jobueh/PUDDING/librelane/runs/RUN_2025-08-30_15-12-42/76-klayout-opengui/klayout_printout.pdf

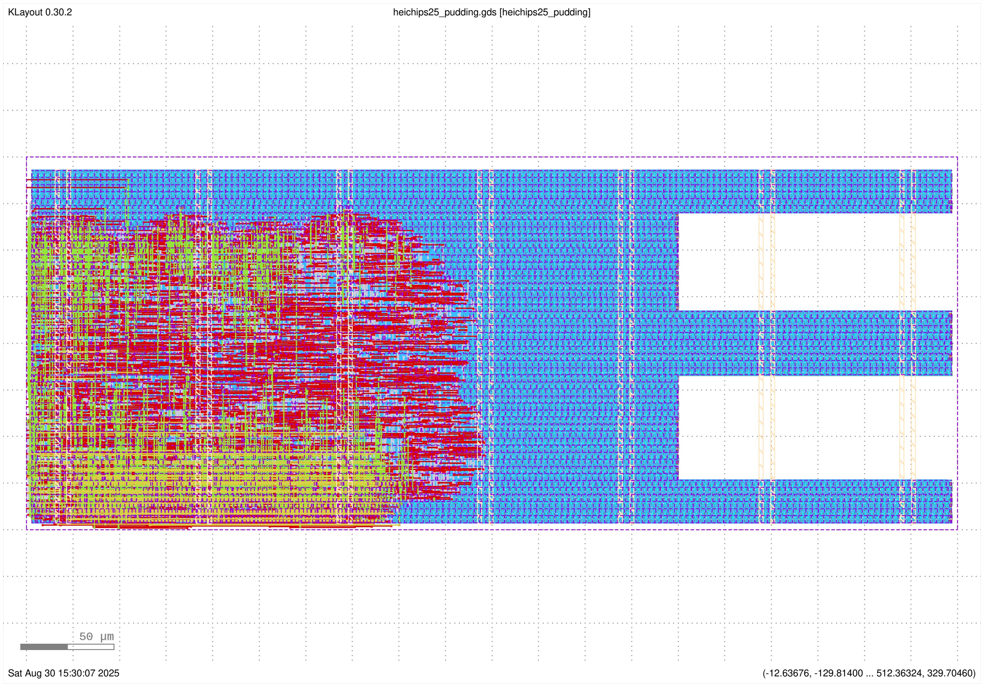
[picture p6: page 1]

KLayout 0.30.2 | heichips25_pudding.gds [heichips25_pudding]
Sat Aug 30 15:30:07 2025 | (-12.63676, -129.81400 ... 512.36324, 329.70460)
