jobueh/PUDDING/gds/dac128module_extracted.cir

* Extracted by KLayout with SG13G2 LVS runset on : 09/02/2026 02:44

.SUBCKT dac128module VSS EN[0]|INP|ON ENB[0]|INN|ONB INP|ON|ON[0]
+ INN|ONB|ONB[0] INP|ON|ON[1] INN|ONB|ONB[1] INP|ON|ON[2] INN|ONB|ONB[2]
+ INP|ON|ON[3] INN|ONB|ONB[3] VDD INP|ON|ON[4] INN|ONB|ONB[4] INP|ON|ON[5]
+ INN|ONB|ONB[5] INP|ON|ON[6] INN|ONB|ONB[6] INP|ON|ON[7] INN|ONB|ONB[7]
+ INP|ON|ON[8] INN|ONB|ONB[8] INP|ON|ON[9] INN|ONB|ONB[9] INP|ON|ON[10]
+ INN|ONB|ONB[10] INP|ON|ON[11] INN|ONB|ONB[11] INP|ON|ON[12] INN|ONB|ONB[12]
+ INP|ON|ON[13] INN|ONB|ONB[13] INP|ON|ON[14] INN|ONB|ONB[14] INP|ON|ON[15]
+ INN|ONB|ONB[15] INP|ON|ON[16] INN|ONB|ONB[16] INP|ON|ON[17] INN|ONB|ONB[17]
+ INP|ON|ON[18] INN|ONB|ONB[18] INP|ON|ON[19] INN|ONB|ONB[19] INP|ON|ON[20]
+ INN|ONB|ONB[20] INP|ON|ON[21] INN|ONB|ONB[21] INP|ON|ON[22] INN|ONB|ONB[22]
+ INP|ON|ON[23] INN|ONB|ONB[23] INP|ON|ON[24] INN|ONB|ONB[24] INP|ON|ON[25]
+ INN|ONB|ONB[25] INP|ON|ON[26] INN|ONB|ONB[26] INP|ON|ON[27] INN|ONB|ONB[27]
+ INP|ON|ON[28] INN|ONB|ONB[28] INP|ON|ON[29] INN|ONB|ONB[29] INP|ON|ON[30]
+ INN|ONB|ONB[30] INP|ON|ON[31] INN|ONB|ONB[31] INP|ON|ON[32] INN|ONB|ONB[32]
+ INP|ON|ON[33] INN|ONB|ONB[33] INP|ON|ON[34] INN|ONB|ONB[34] INP|ON|ON[35]
+ INN|ONB|ONB[35] INP|ON|ON[36] INN|ONB|ONB[36] INP|ON|ON[37] INN|ONB|ONB[37]
+ INP|ON|ON[38] INN|ONB|ONB[38] INP|ON|ON[39] INN|ONB|ONB[39] INP|ON|ON[40]
+ INN|ONB|ONB[40] INP|ON|ON[41] INN|ONB|ONB[41] INP|ON|ON[42] INN|ONB|ONB[42]
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
+ AD=0.162p PS=1.14u PD=2.16u
M$203 OUTN$50 OUTP$50 VSS VSS sg13_lv_nmos L=0.52u W=0.15u AS=0.162p AD=0.0855p
+ PS=2.16u PD=1.14u
M$204 VSS OUTN$50 OUTP$50 VSS sg13_lv_nmos L=0.52u W=0.15u AS=0.0855p AD=0.162p
+ PS=1.14u PD=2.16u
M$205 OUTN$51 OUTP$51 VSS VSS sg13_lv_nmos L=0.52u W=0.15u AS=0.162p AD=0.0855p
+ PS=2.16u PD=1.14u
M$206 VSS OUTN$51 OUTP$51 VSS sg13_lv_nmos L=0.52u W=0.15u AS=0.0855p AD=0.162p
+ PS=1.14u PD=2.16u
M$207 OUTP$117 OUTN$117 VSS VSS sg13_lv_nmos L=0.52u W=0.15u AS=0.162p
+ AD=0.0855p PS=2.16u PD=1.14u
M$208 VSS OUTP$117 OUTN$117 VSS sg13_lv_nmos L=0.52u W=0.15u AS=0.0855p
+ AD=0.162p PS=1.14u PD=2.16u
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
