jobueh/PUDDING/gds/DAC2U64OUT2IN_extracted.cir

* Extracted by KLayout with SG13G2 LVS runset on : 09/02/2026 02:19

.SUBCKT DAC2U64OUT2IN VSS EN[0]|ON ENB[0]|ONB ON|ON[0] ONB|ONB[0] ON|ON[1]
+ ONB|ONB[1] ONB|ONB[2] ON|ON[3] ONB|ONB[3] ON|ON[4] ONB|ONB[4] ON|ON[5]
+ ONB|ONB[5] ON|ON[6] ONB|ONB[6] ON|ON[7] ONB|ONB[7] ONB|ONB[8] ON|ON[9]
+ ONB|ONB[9] ON|ON[10] ONB|ONB[10] ONB|ONB[11] ONB|ONB[12] ONB|ONB[13]
+ ONB|ONB[14] ON|ON[15] ONB|ONB[15] ON|ON[16] ONB|ONB[16] ONB|ONB[17]
+ ONB|ONB[18] ON|ON[19] ONB|ONB[19] ONB|ONB[20] ONB|ONB[21] ON|ON[22]
+ ONB|ONB[22] ONB|ONB[23] ON|ON[24] ONB|ONB[24] ONB|ONB[25] ONB|ONB[26]
+ ONB|ONB[27] ONB|ONB[28] ONB|ONB[29] ONB|ONB[30] ON|ON[31] ONB|ONB[31]
+ ON|ON[32] ONB|ONB[32] ONB|ONB[33] ONB|ONB[34] ONB|ONB[35] ON|ON[36]
+ ONB|ONB[36] ONB|ONB[37] ONB|ONB[38] ONB|ONB[39] ONB|ONB[40] ONB|ONB[41]
+ ONB|ONB[42] ONB|ONB[43] ONB|ONB[44] ONB|ONB[45] ON|ON[46] ONB|ONB[46]
+ ON|ON[47] ONB|ONB[47] ONB|ONB[48] ONB|ONB[49] ON|ON[50] ONB|ONB[50]
+ ONB|ONB[51] ON|ON[52] ONB|ONB[52] ON|ON[53] ONB|ONB[53] ONB|ONB[54]
+ ONB|ONB[55] ONB|ONB[56] ON|ON[57] ONB|ONB[57] ONB|ONB[58] ONB|ONB[59]
+ ON|ON[60] ONB|ONB[60] ON|ON[61] ONB|ONB[61] ONB|ONB[62] ON|ON[63] ONB|ONB[63]
+ ENB[1]|ONB ON|ON[2] ON|ON[8] ON|ON[11] ON|ON[12] ON|ON[13] ON|ON[14]
+ ON|ON[17] ON|ON[18] ON|ON[20] ON|ON[21] ON|ON[23] ON|ON[25] ON|ON[26]
+ ON|ON[27] ON|ON[28] ON|ON[29] ON|ON[30] ON|ON[33] ON|ON[34] ON|ON[35]
+ ON|ON[37] ON|ON[38] ON|ON[39] ON|ON[40] ON|ON[41] ON|ON[42] ON|ON[43]
+ ON|ON[44] ON|ON[45] ON|ON[48] ON|ON[49] ON|ON[51] ON|ON[54] ON|ON[55]
+ ON|ON[56] ON|ON[58] ON|ON[59] ON|ON[62] EN[1]|ON VDD VcascP VbiasP Iout
M$1 \$95 \$96 VSS VSS sg13_lv_nmos L=0.52u W=0.15u AS=0.162p AD=0.0855p
+ PS=2.16u PD=1.14u
M$2 VSS \$95 \$96 VSS sg13_lv_nmos L=0.52u W=0.15u AS=0.0855p AD=0.162p
+ PS=1.14u PD=2.16u
M$3 \$97 \$98 VSS VSS sg13_lv_nmos L=0.52u W=0.15u AS=0.162p AD=0.0855p
+ PS=2.16u PD=1.14u
M$4 VSS \$97 \$98 VSS sg13_lv_nmos L=0.52u W=0.15u AS=0.0855p AD=0.162p
+ PS=1.14u PD=2.16u
M$5 \$99 \$100 VSS VSS sg13_lv_nmos L=0.52u W=0.15u AS=0.162p AD=0.0855p
+ PS=2.16u PD=1.14u
M$6 VSS \$99 \$100 VSS sg13_lv_nmos L=0.52u W=0.15u AS=0.0855p AD=0.162p
+ PS=1.14u PD=2.16u
M$7 \$101 \$102 VSS VSS sg13_lv_nmos L=0.52u W=0.15u AS=0.162p AD=0.0855p
+ PS=2.16u PD=1.14u
M$8 VSS \$101 \$102 VSS sg13_lv_nmos L=0.52u W=0.15u AS=0.0855p AD=0.162p
+ PS=1.14u PD=2.16u
M$9 \$103 \$104 VSS VSS sg13_lv_nmos L=0.52u W=0.15u AS=0.162p AD=0.0855p
+ PS=2.16u PD=1.14u
M$10 VSS \$103 \$104 VSS sg13_lv_nmos L=0.52u W=0.15u AS=0.0855p AD=0.162p
+ PS=1.14u PD=2.16u
M$11 \$105 \$106 VSS VSS sg13_lv_nmos L=0.52u W=0.15u AS=0.162p AD=0.0855p
+ PS=2.16u PD=1.14u
M$12 VSS \$105 \$106 VSS sg13_lv_nmos L=0.52u W=0.15u AS=0.0855p AD=0.162p
+ PS=1.14u PD=2.16u
M$13 \$107 \$108 VSS VSS sg13_lv_nmos L=0.52u W=0.15u AS=0.162p AD=0.0855p
+ PS=2.16u PD=1.14u
M$14 VSS \$107 \$108 VSS sg13_lv_nmos L=0.52u W=0.15u AS=0.0855p AD=0.162p
+ PS=1.14u PD=2.16u
M$15 \$109 \$110 VSS VSS sg13_lv_nmos L=0.52u W=0.15u AS=0.162p AD=0.0855p
+ PS=2.16u PD=1.14u
M$16 VSS \$109 \$110 VSS sg13_lv_nmos L=0.52u W=0.15u AS=0.0855p AD=0.162p
+ PS=1.14u PD=2.16u
M$17 \$111 \$112 VSS VSS sg13_lv_nmos L=0.52u W=0.15u AS=0.162p AD=0.0855p
+ PS=2.16u PD=1.14u
M$18 VSS \$111 \$112 VSS sg13_lv_nmos L=0.52u W=0.15u AS=0.0855p AD=0.162p
+ PS=1.14u PD=2.16u
M$19 \$113 \$114 VSS VSS sg13_lv_nmos L=0.52u W=0.15u AS=0.162p AD=0.0855p
+ PS=2.16u PD=1.14u
M$20 VSS \$113 \$114 VSS sg13_lv_nmos L=0.52u W=0.15u AS=0.0855p AD=0.162p
+ PS=1.14u PD=2.16u
M$21 \$115 \$116 VSS VSS sg13_lv_nmos L=0.52u W=0.15u AS=0.162p AD=0.0855p
+ PS=2.16u PD=1.14u
M$22 VSS \$115 \$116 VSS sg13_lv_nmos L=0.52u W=0.15u AS=0.0855p AD=0.162p
+ PS=1.14u PD=2.16u
M$23 \$117 \$118 VSS VSS sg13_lv_nmos L=0.52u W=0.15u AS=0.162p AD=0.0855p
+ PS=2.16u PD=1.14u
M$24 VSS \$117 \$118 VSS sg13_lv_nmos L=0.52u W=0.15u AS=0.0855p AD=0.162p
+ PS=1.14u PD=2.16u
M$25 \$119 \$120 VSS VSS sg13_lv_nmos L=0.52u W=0.15u AS=0.162p AD=0.0855p
+ PS=2.16u PD=1.14u
M$26 VSS \$119 \$120 VSS sg13_lv_nmos L=0.52u W=0.15u AS=0.0855p AD=0.162p
+ PS=1.14u PD=2.16u
M$27 \$121 \$122 VSS VSS sg13_lv_nmos L=0.52u W=0.15u AS=0.162p AD=0.0855p
+ PS=2.16u PD=1.14u
M$28 VSS \$121 \$122 VSS sg13_lv_nmos L=0.52u W=0.15u AS=0.0855p AD=0.162p
+ PS=1.14u PD=2.16u
M$29 \$123 \$124 VSS VSS sg13_lv_nmos L=0.52u W=0.15u AS=0.162p AD=0.0855p
+ PS=2.16u PD=1.14u
M$30 VSS \$123 \$124 VSS sg13_lv_nmos L=0.52u W=0.15u AS=0.0855p AD=0.162p
+ PS=1.14u PD=2.16u
M$31 \$125 \$126 VSS VSS sg13_lv_nmos L=0.52u W=0.15u AS=0.162p AD=0.0855p
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
M$288 \$279 \$118 VDD VDD sg13_lv_pmos L=0.13u W=0.3u AS=0.057p AD=0.102p
+ PS=0.68u PD=1.28u
M$289 VcascP \$119 \$280 VDD sg13_lv_pmos L=0.13u W=0.3u AS=0.102p AD=0.057p
+ PS=1.28u PD=0.68u
M$290 \$280 \$120 VDD VDD sg13_lv_pmos L=0.13u W=0.3u AS=0.057p AD=0.102p
+ PS=0.68u PD=1.28u
M$291 VcascP \$121 \$281 VDD sg13_lv_pmos L=0.13u W=0.3u AS=0.102p AD=0.057p
+ PS=1.28u PD=0.68u
M$292 \$281 \$122 VDD VDD sg13_lv_pmos L=0.13u W=0.3u AS=0.057p AD=0.102p
+ PS=0.68u PD=1.28u
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
