jobueh/PUDDING/macro/spice/heichips25_pudding.spice

* NGSPICE file created from heichips25_pudding.ext - technology: ihp-sg13g2

* Black-box entry subcircuit for sg13g2_decap_8 abstract view
.subckt sg13g2_decap_8 VDD VSS
.ends

* Black-box entry subcircuit for sg13g2_nand2_1 abstract view
.subckt sg13g2_nand2_1 Y A B VDD VSS
.ends

* Black-box entry subcircuit for sg13g2_fill_1 abstract view
.subckt sg13g2_fill_1 VDD VSS
.ends

* Black-box entry subcircuit for sg13g2_tiehi abstract view
.subckt sg13g2_tiehi VDD VSS L_HI
.ends

* Black-box entry subcircuit for sg13g2_fill_2 abstract view
.subckt sg13g2_fill_2 VDD VSS
.ends

* Black-box entry subcircuit for sg13g2_decap_4 abstract view
.subckt sg13g2_decap_4 VDD VSS
.ends

* Black-box entry subcircuit for sg13g2_mux2_1 abstract view
.subckt sg13g2_mux2_1 A0 A1 S X VDD VSS
.ends

* Black-box entry subcircuit for sg13g2_buf_1 abstract view
.subckt sg13g2_buf_1 A X VDD VSS
.ends

* Black-box entry subcircuit for sg13g2_a21oi_1 abstract view
.subckt sg13g2_a21oi_1 VSS VDD A1 A2 Y B1
.ends

* Black-box entry subcircuit for sg13g2_inv_1 abstract view
.subckt sg13g2_inv_1 VDD Y A VSS
.ends

* Black-box entry subcircuit for sg13g2_dfrbpq_1 abstract view
.subckt sg13g2_dfrbpq_1 RESET_B VSS VDD D Q CLK
.ends

* Black-box entry subcircuit for sg13g2_o21ai_1 abstract view
.subckt sg13g2_o21ai_1 B1 VDD Y VSS A1 A2
.ends

* Black-box entry subcircuit for sg13g2_buf_8 abstract view
.subckt sg13g2_buf_8 A X VDD VSS
.ends

* Black-box entry subcircuit for sg13g2_buf_16 abstract view
.subckt sg13g2_buf_16 X A VDD VSS
.ends

* Black-box entry subcircuit for sg13g2_inv_2 abstract view
.subckt sg13g2_inv_2 Y A VDD VSS
.ends

* Black-box entry subcircuit for sg13g2_inv_8 abstract view
.subckt sg13g2_inv_8 Y A VDD VSS
.ends

* Black-box entry subcircuit for dac128module abstract view
.subckt dac128module VbiasP[1] IOUT VbiasP[0] ON[64] ONB[64] ON[65] ONB[65] ON[66]
+ ONB[66] ON[67] ONB[67] ON[68] ONB[68] ON[69] ONB[69] ON[70] ONB[70] ON[71] ONB[71]
+ ON[72] ONB[72] EN[2] ENB[2] ON[73] ONB[73] ON[74] ONB[74] ON[75] ONB[75] ON[76]
+ ONB[76] ON[77] ONB[77] ON[78] ONB[78] ON[79] ONB[79] ON[80] ONB[80] ON[81] ONB[81]
+ ON[82] ONB[82] ON[83] ONB[83] ON[84] ONB[84] ON[85] ONB[85] ON[86] ONB[86] ON[87]
+ ONB[87] ON[88] ONB[88] ON[89] ONB[89] ON[90] ONB[90] ON[91] ONB[91] ON[92] ONB[92]
+ ON[93] ONB[93] ON[94] ONB[94] ON[95] ONB[95] ON[96] ONB[96] ON[97] ONB[97] ON[98]
+ ONB[98] ON[99] ONB[99] ON[100] ONB[100] ON[101] ONB[101] ON[102] ONB[102] ON[103]
+ ONB[103] ON[104] ONB[104] ON[105] ONB[105] ON[106] ONB[106] ON[107] ONB[107] ON[108]
+ ONB[108] ON[109] ONB[109] ON[110] ONB[110] ON[111] ONB[111] ON[112] ONB[112] ON[113]
+ ONB[113] ON[114] ONB[114] ON[115] ONB[115] ON[116] ONB[116] ON[117] ONB[117] ON[118]
+ ONB[118] ON[119] ONB[119] ON[120] ONB[120] ON[121] ONB[121] ON[122] ONB[122] EN[3]
+ ENB[3] ON[123] ONB[123] ON[124] ONB[124] ON[125] ONB[125] ON[126] ONB[126] ON[127]
+ ONB[127] ON[0] ONB[0] ON[1] ONB[1] ON[2] ONB[2] ON[3] ONB[3] ON[4] ONB[4] ON[5]
+ ONB[5] ON[6] EN[0] ENB[0] ONB[6] ON[7] ONB[7] ON[8] ONB[8] ON[9] ONB[9] ON[10] ONB[10]
+ ON[11] ONB[11] ON[12] ONB[12] ON[13] ONB[13] ON[14] ONB[14] ON[15] ONB[15] ON[16]
+ ONB[16] ON[17] ONB[17] ON[18] ONB[18] ON[19] ONB[19] ON[20] ONB[20] ON[21] ONB[21]
+ ON[22] ONB[22] ON[23] ONB[23] ON[24] ONB[24] ON[25] ONB[25] ON[26] ONB[26] ON[27]
+ ONB[27] ON[28] ONB[28] ON[29] ONB[29] ON[30] ONB[30] ON[31] ONB[31] ON[33] ONB[33]
+ ON[32] ONB[32] ON[34] ONB[34] ON[35] ONB[35] ON[36] ONB[36] ON[37] ONB[37] ON[38]
+ ONB[38] ON[39] ONB[39] ON[40] ONB[40] ON[41] ONB[41] ON[42] ONB[42] ON[43] ONB[43]
+ ON[44] ONB[44] ON[45] ONB[45] ON[46] ONB[46] ON[47] ONB[47] ON[48] ONB[48] ON[49]
+ ONB[49] ON[50] ONB[50] ON[51] ONB[51] ON[52] ONB[52] ON[53] ONB[53] ON[54] ONB[54]
+ ON[55] ONB[55] ON[56] ONB[56] ON[57] ONB[57] ON[58] ONB[58] ON[59] ONB[59] ON[60]
+ ONB[60] ON[61] ONB[61] ON[62] ONB[62] ON[63] ONB[63] EN[1] ENB[1] VcascP[1] VcascP[0]
+ VSS VDD
.ends

* Black-box entry subcircuit for sg13g2_or2_1 abstract view
.subckt sg13g2_or2_1 VSS VDD X B A
.ends

* Black-box entry subcircuit for sg13g2_nor2_1 abstract view
.subckt sg13g2_nor2_1 A B Y VDD VSS
.ends

.subckt heichips25_pudding VGND VPWR clk ena i_in i_out rst_n ui_in[0] ui_in[1] ui_in[2]
+ ui_in[3] ui_in[4] ui_in[5] ui_in[6] ui_in[7] uio_in[0] uio_in[1] uio_in[2] uio_in[3]
+ uio_in[4] uio_in[5] uio_in[6] uio_in[7] uio_oe[0] uio_oe[1] uio_oe[2] uio_oe[3]
+ uio_oe[4] uio_oe[5] uio_oe[6] uio_oe[7] uio_out[0] uio_out[1] uio_out[2] uio_out[3]
+ uio_out[4] uio_out[5] uio_out[6] uio_out[7] uo_out[0] uo_out[1] uo_out[2] uo_out[3]
+ uo_out[4] uo_out[5] uo_out[6] uo_out[7]
XFILLER_39_266 VPWR VGND sg13g2_decap_8
X_2106_ _0743_ net100 state\[25\] VPWR VGND sg13g2_nand2_1
X_2037_ _0703_ net156 _0702_ VPWR VGND sg13g2_nand2_1
XFILLER_36_973 VPWR VGND sg13g2_decap_8
XFILLER_35_483 VPWR VGND sg13g2_decap_8
XFILLER_11_807 VPWR VGND sg13g2_fill_1
X_2350__252 VPWR VGND net251 sg13g2_tiehi
XFILLER_22_144 VPWR VGND sg13g2_decap_8
XFILLER_10_339 VPWR VGND sg13g2_decap_8
X_2426__356 VPWR VGND net355 sg13g2_tiehi
XFILLER_7_7 VPWR VGND sg13g2_fill_1
XFILLER_2_549 VPWR VGND sg13g2_decap_8
XFILLER_18_417 VPWR VGND sg13g2_decap_8
XFILLER_45_203 VPWR VGND sg13g2_decap_8
XFILLER_26_41 VPWR VGND sg13g2_fill_1
XFILLER_42_932 VPWR VGND sg13g2_fill_1
XFILLER_26_63 VPWR VGND sg13g2_fill_2
XFILLER_26_483 VPWR VGND sg13g2_decap_8
XFILLER_13_122 VPWR VGND sg13g2_decap_8
XFILLER_41_420 VPWR VGND sg13g2_decap_8
XFILLER_26_494 VPWR VGND sg13g2_fill_2
XFILLER_13_199 VPWR VGND sg13g2_decap_8
XFILLER_9_126 VPWR VGND sg13g2_decap_8
XFILLER_41_497 VPWR VGND sg13g2_decap_8
XFILLER_42_84 VPWR VGND sg13g2_decap_8
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
X_2335_ net281 VGND VPWR _0151_ daisychain\[23\] clknet_leaf_14_clk sg13g2_dfrbpq_1
XFILLER_29_108 VPWR VGND sg13g2_decap_8
X_2266_ _0823_ net104 state\[105\] VPWR VGND sg13g2_nand2_1
X_2197_ VGND VPWR _0487_ _0788_ _0326_ net86 sg13g2_a21oi_1
XFILLER_1_91 VPWR VGND sg13g2_decap_8
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
