jobueh/PUDDING/xschem/simulation/dac128module.spice

** sch_path: /home/cmaier/EDA/PUDDING/xschem/dac128module.sch
.subckt dac128module Iout ON[63] ON[62] ON[61] ON[60] ON[59] ON[58] ON[57] ON[56] ON[55] ON[54] ON[53] ON[52] ON[51] ON[50] ON[49]
+ ON[48] ON[47] ON[46] ON[45] ON[44] ON[43] ON[42] ON[41] ON[40] ON[39] ON[38] ON[37] ON[36] ON[35] ON[34] ON[33] ON[32] ON[31] ON[30]
+ ON[29] ON[28] ON[27] ON[26] ON[25] ON[24] ON[23] ON[22] ON[21] ON[20] ON[19] ON[18] ON[17] ON[16] ON[15] ON[14] ON[13] ON[12] ON[11]
+ ON[10] ON[9] ON[8] ON[7] ON[6] ON[5] ON[4] ON[3] ON[2] ON[1] ON[0] ONB[63] ONB[62] ONB[61] ONB[60] ONB[59] ONB[58] ONB[57] ONB[56]
+ ONB[55] ONB[54] ONB[53] ONB[52] ONB[51] ONB[50] ONB[49] ONB[48] ONB[47] ONB[46] ONB[45] ONB[44] ONB[43] ONB[42] ONB[41] ONB[40] ONB[39]
+ ONB[38] ONB[37] ONB[36] ONB[35] ONB[34] ONB[33] ONB[32] ONB[31] ONB[30] ONB[29] ONB[28] ONB[27] ONB[26] ONB[25] ONB[24] ONB[23] ONB[22]
+ ONB[21] ONB[20] ONB[19] ONB[18] ONB[17] ONB[16] ONB[15] ONB[14] ONB[13] ONB[12] ONB[11] ONB[10] ONB[9] ONB[8] ONB[7] ONB[6] ONB[5] ONB[4]
+ ONB[3] ONB[2] ONB[1] ONB[0] VSS VDD Vpcbias[0] EN[1] EN[0] ENB[1] ENB[0] ON[127] ON[126] ON[125] ON[124] ON[123] ON[122] ON[121] ON[120]
+ ON[119] ON[118] ON[117] ON[116] ON[115] ON[114] ON[113] ON[112] ON[111] ON[110] ON[109] ON[108] ON[107] ON[106] ON[105] ON[104] ON[103]
+ ON[102] ON[101] ON[100] ON[99] ON[98] ON[97] ON[96] ON[95] ON[94] ON[93] ON[92] ON[91] ON[90] ON[89] ON[88] ON[87] ON[86] ON[85] ON[84]
+ ON[83] ON[82] ON[81] ON[80] ON[79] ON[78] ON[77] ON[76] ON[75] ON[74] ON[73] ON[72] ON[71] ON[70] ON[69] ON[68] ON[67] ON[66] ON[65]
+ ON[64] ONB[127] ONB[126] ONB[125] ONB[124] ONB[123] ONB[122] ONB[121] ONB[120] ONB[119] ONB[118] ONB[117] ONB[116] ONB[115] ONB[114]
+ ONB[113] ONB[112] ONB[111] ONB[110] ONB[109] ONB[108] ONB[107] ONB[106] ONB[105] ONB[104] ONB[103] ONB[102] ONB[101] ONB[100] ONB[99]
+ ONB[98] ONB[97] ONB[96] ONB[95] ONB[94] ONB[93] ONB[92] ONB[91] ONB[90] ONB[89] ONB[88] ONB[87] ONB[86] ONB[85] ONB[84] ONB[83] ONB[82]
+ ONB[81] ONB[80] ONB[79] ONB[78] ONB[77] ONB[76] ONB[75] ONB[74] ONB[73] ONB[72] ONB[71] ONB[70] ONB[69] ONB[68] ONB[67] ONB[66] ONB[65]
+ ONB[64] EN[3] EN[2] ENB[3] ENB[2] Vpcbias[1]
*.PININFO Iout:O ON[63:0]:I ONB[63:0]:I VSS:B VDD:B Vpcbias[0]:B EN[1:0]:I ENB[1:0]:I ON[127:64]:I ONB[127:64]:I EN[3:2]:I
*+ ENB[3:2]:I Vpcbias[1]:B
Mcbias[0] Vpcbias[0] Vpcbias[0] Vpbias[0] VDD sg13_lv_pmos w=5.85u l=0.15u ng=1 m=2
xref[1] VDD Vpbias[0] EN[1] ENB[1] Vpbias[0] Vpcbias[0] VSS unitsource2u
xref[0] VDD Vpbias[0] EN[0] ENB[0] Vpbias[0] Vpcbias[0] VSS unitsource2u
xsrc[63] VDD Vpbias[0] ON[63] ONB[63] Iout Vpcbias[0] VSS unitsource2u
xsrc[62] VDD Vpbias[0] ON[62] ONB[62] Iout Vpcbias[0] VSS unitsource2u
xsrc[61] VDD Vpbias[0] ON[61] ONB[61] Iout Vpcbias[0] VSS unitsource2u
xsrc[60] VDD Vpbias[0] ON[60] ONB[60] Iout Vpcbias[0] VSS unitsource2u
xsrc[59] VDD Vpbias[0] ON[59] ONB[59] Iout Vpcbias[0] VSS unitsource2u
xsrc[58] VDD Vpbias[0] ON[58] ONB[58] Iout Vpcbias[0] VSS unitsource2u
xsrc[57] VDD Vpbias[0] ON[57] ONB[57] Iout Vpcbias[0] VSS unitsource2u
xsrc[56] VDD Vpbias[0] ON[56] ONB[56] Iout Vpcbias[0] VSS unitsource2u
xsrc[55] VDD Vpbias[0] ON[55] ONB[55] Iout Vpcbias[0] VSS unitsource2u
xsrc[54] VDD Vpbias[0] ON[54] ONB[54] Iout Vpcbias[0] VSS unitsource2u
xsrc[53] VDD Vpbias[0] ON[53] ONB[53] Iout Vpcbias[0] VSS unitsource2u
xsrc[52] VDD Vpbias[0] ON[52] ONB[52] Iout Vpcbias[0] VSS unitsource2u
xsrc[51] VDD Vpbias[0] ON[51] ONB[51] Iout Vpcbias[0] VSS unitsource2u
xsrc[50] VDD Vpbias[0] ON[50] ONB[50] Iout Vpcbias[0] VSS unitsource2u
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
