jobueh/PUDDING/librelane/runs/RUN_2026-02-11_00-01-28/final/nl/heichips25_pudding.nl.v

module heichips25_pudding (clk,
    ena,
    rst_n,
    ui_in,
    uio_in,
    uio_oe,
    uio_out,
    uo_out);
 input clk;
 input ena;
 input rst_n;
 input [7:0] ui_in;
 input [7:0] uio_in;
 output [7:0] uio_oe;
 output [7:0] uio_out;
 output [7:0] uo_out;

 wire _0000_;
 wire _0001_;
 wire _0002_;
 wire _0003_;
 wire _0004_;
 wire _0005_;
 wire _0006_;
 wire _0007_;
 wire _0008_;
 wire _0009_;
 wire _0010_;
 wire _0011_;
 wire _0012_;
 wire _0013_;
 wire _0014_;
 wire _0015_;
 wire _0016_;
 wire _0017_;
 wire _0018_;
 wire _0019_;
 wire _0020_;
 wire _0021_;
 wire _0022_;
 wire _0023_;
 wire _0024_;
 wire _0025_;
 wire _0026_;
 wire _0027_;
 wire _0028_;
 wire _0029_;
 wire _0030_;
 wire _0031_;
 wire _0032_;
 wire _0033_;
 wire _0034_;
 wire _0035_;
 wire _0036_;
 wire _0037_;
 wire _0038_;
 wire _0039_;
 wire _0040_;
 wire _0041_;
 wire _0042_;
 wire _0043_;
 wire _0044_;
 wire _0045_;
 wire _0046_;
 wire _0047_;
 wire _0048_;
 wire _0049_;
 wire _0050_;
 wire _0051_;
 wire _0052_;
 wire _0053_;
 wire _0054_;
 wire _0055_;
 wire _0056_;
 wire _0057_;
 wire _0058_;
 wire _0059_;
 wire _0060_;
 wire _0061_;
 wire _0062_;
 wire _0063_;
 wire _0064_;
 wire _0065_;
 wire _0066_;
 wire _0067_;
 wire _0068_;
 wire _0069_;
 wire _0070_;
 wire _0071_;
 wire _0072_;
 wire _0073_;
 wire _0074_;
 wire _0075_;
 wire _0076_;
 wire _0077_;
 wire _0078_;
 wire _0079_;
 wire _0080_;
 wire _0081_;
 wire _0082_;
 wire _0083_;
 wire _0084_;
 wire _0085_;
 wire _0086_;
 wire _0087_;
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
    .D(_0293_),
    .Q(\daisychain[37] ),
    .CLK(clknet_leaf_17_clk));
 sg13g2_dfrbpq_1 _2348_ (.RESET_B(net407),
    .D(_0294_),
    .Q(\daisychain[38] ),
    .CLK(clknet_leaf_13_clk));
 sg13g2_dfrbpq_1 _2349_ (.RESET_B(net405),
    .D(_0295_),
    .Q(\daisychain[39] ),
    .CLK(clknet_leaf_12_clk));
 sg13g2_dfrbpq_1 _2350_ (.RESET_B(net403),
    .D(_0296_),
    .Q(\daisychain[40] ),
    .CLK(clknet_leaf_12_clk));
 sg13g2_dfrbpq_1 _2351_ (.RESET_B(net401),
    .D(_0297_),
    .Q(\daisychain[41] ),
    .CLK(clknet_leaf_13_clk));
 sg13g2_dfrbpq_1 _2352_ (.RESET_B(net399),
    .D(_0298_),
    .Q(\daisychain[42] ),
    .CLK(clknet_leaf_13_clk));
 sg13g2_dfrbpq_1 _2353_ (.RESET_B(net397),
    .D(_0299_),
    .Q(\daisychain[43] ),
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
