jobueh/PUDDING/src/heichips25_pudding.sv

// SPDX-FileCopyrightText: © 2025 Luis Ardila, Jonas Buehler, Christoph Maier
// SPDX-License-Identifier: Apache-2.0

// Adapted from the Tiny Tapeout template
// minimum design: 128 DAC sources only

`default_nettype none

module heichips25_pudding(
    input  wire [7:0] ui_in,    // Dedicated inputs
    output wire [7:0] uo_out,   // Dedicated outputs
    input  wire [7:0] uio_in,   // IOs: Input path
    output wire [7:0] uio_out,  // IOs: Output path
    output wire [7:0] uio_oe,   // IOs: Enable path (active high: 0=input, 1=output)
    input  wire       ena,      // always 1 when the design is powered, so you can ignore it
    input  wire       clk,      // clock
    input  wire       rst_n,    // reset_n - low to reset
    inout  wire       i_in,	// input (reference) current
    inout  wire       i_out,	// output (DAC) current
    inout VPWR,
    inout VGND
);

//(* keep = "yes" *) wire VPWR;
//(* keep = "yes" *) wire VGND;
   
    // List all unused inputs to prevent warnings
    wire[1:0] iref;
    wire[1:0] bias;
    wire _unused = &{ena, uio_in[7:0], ui_in[7:5], bias};

    logic[3:0] stateen, stateenp, stateenn;

    logic datum, shift, transfer, dir;

    logic[127:0] daisychain;
    logic[127:0] state;

    assign iref     = {2{i_in}};
    assign datum    = ui_in[0];
    assign shift    = ui_in[1];
    assign transfer = ui_in[2];
    assign dir      = ui_in[3];

    assign stateen = {4{ui_in[4]}};

    always_ff @(posedge clk) 
    begin
        if (!rst_n) 
        begin
            daisychain <= '0;
            state <= '0;
        end 
        else 
        begin
            if (transfer) 
            begin
                if (dir)
                    state <= daisychain;
                else
                    daisychain <= state;
            end
            else if (shift)
            begin
                daisychain <= {daisychain[126:0],datum};
            end
        end
    end

    
assign uo_out  = daisychain[127:120];
assign uio_out = state[127:120];
assign uio_oe  = 8'hFF;

    digital4 digitalen (
    .in(stateen[3:0]),
    .outp(stateenp[3:0]),
    .outn(stateenn[3:0])
    );


(* keep_hierarchy = "yes", keep = "yes" *) dac128module dac (
    .IOUT(i_out),
    .VcascP(iref),
    .VbiasP(bias),
    .ON(state[127:0]),
    .ONB(~state[127:0]),
    .EN(stateenp[3:0]),
    .ENB(stateenn[3:0]),
    .VDD(VPWR),
    .VSS(VGND)
    );

endmodule

module digital4(
    input  logic [3:0] in,
    output logic [3:0] outn,
    output logic [3:0] outp
);
    // 4 instances, each bit wired to one instance
  genvar i;
      for (i = 0; i < 4; i++) begin : g
          inverterpair u (
              .IN   (in[i]),
              .OUTN (outn[i]),
              .OUTP (outp[i])
          );
  end
endmodule

// File: inverterpair.sv
// SystemVerilog: simple ON - ON_N logic for the current mirrors

module inverterpair (
    input logic IN,
    output logic OUTN,
    output logic OUTP
);
(* keep *) sg13g2_inv_1 inv1 (.Y(OUTN), .A(IN));
(* keep *) sg13g2_inv_1 inv2 (.Y(OUTP), .A(OUTN));
endmodule
