jobueh/PUDDING/src/dac128module.v

// File: dac128module.v
// SystemVerilog: 128 unit source DAC module digital placeholder
// Yosys hints: blackbox + keep_hierarchy.
(* blackbox *)
module dac128module (
    inout IOUT,
    inout [1:0] VcascP,
    inout [1:0] VbiasP,
    input [127:0] ON,
    input [127:0] ONB,
    input [3:0] EN,
    input [3:0] ENB,
    inout VDD,
    inout VSS
);
endmodule
