jobueh/PUDDING/(commit log)

2025-08-07 calls.txt : notes on calling tools in the chain
2025-08-07 Add schematics
    [DAC_SW.sch, DAC_TOP.sch, Pmirror_StdCell.sch, Pmirrors_top.sch]
2025-08-08 xschem/*.sch *.sym * moved from schematic
    [DAC_SW.sch, DAC_TOP.sch, Pmirror_StdCell.sch, Pmirrors_top.sch]
2025-08-08 xschem/DAC_TOP.sch Pmirrors_top.sch : made paths to subcircuits relative, so it works for everybody [?, at least #worksforme]
    [DAC_TOP.sch, Pmirrors_top.sch]
2025-08-08 dac_word_correction code
    Performing correction on the dac data word by interpolation.
    [dac_word_correction.sv]
2025-08-09 DoNotLitter/CryoChips/Design_of_Low-Voltage_and_Low-Power_Cryogenic_CMOS_Voltage_Reference_Circuits.pdf : start literature collection
2025-08-11 AnalogFlow.md README.md : extra markdown page for analog design flow
2025-08-12 gds/pmos_switch_array_botched.gds : botched pcells without n tap and "shared gate strap"
2025-08-14 gds/pcascsrc.gds : add minimum DRC drain contact. w=300nm is minimum width to fit contact
2025-08-14 gds/switched_pmos_cascode.gds python/make_gds.py : minimum DRC clean switched cascode with gate and drain contacts, generating python script
2025-08-14 klayout_printout.pdf : swsources16 printout
2025-08-15 Split ON and ON_N
    [DAC_SW.sch, DAC_SW_TOP.sch, DAC_TOP.sch, DC_sim.sch, Pmirror_StdCell.sch, Pmirrors_top.sch, tran_sim.sch]
2025-08-15 tb/*.sch schematic/*.sch : changed absolute to relative path references for portability
    [DAC_SW_TOP.sch, DAC_TOP.sch, DC_sim.sch, Pmirrors_top.sch, tran_sim.sch]
2025-08-15 tb/DC_sim.sch : fixed mkdir incompatibility
    [DC_sim.sch]
2025-08-15 schematic/simulation/.spiceinit tb/simulation/.spiceinit tb/simulations/.spiceinit : (maybe) redundant copies of .spiceinit to make simulations work
2025-08-16 python/pcell_pmos_switch_array.py gds/pmos_switch_array_botched.gds: still nonsensical ChatGPT cascode switch generator
2025-08-16 xschem/DC_sim.sch tran_sim.sch DAC_TOP.sch DAC_SW_TOP.sch Pmirrors_top.sch : moved from tb and schematic, path fixed to local directory
    [DAC_SW_TOP.sch, DAC_TOP.sch, DC_sim.sch, Pmirrors_top.sch, tran_sim.sch]
2025-08-16 xschem/Nmirror.sch Nmirror.sym : self-cascoded NMOS mirror to generate two DAC bias currents
    [Nmirror.sch]
2025-08-16 flake.nix : add gaw waveform viewer
    [test_Nmirror_DC.sch]
2025-08-16 xschem/Nmirror.sch test_Nmirror_DC.sch : work in progress, try to get a grasp of setting a good operating point
    [Nmirror.sch, test_Nmirror_DC.sch]
2025-08-16 xschem/Nmirror.sch : shotgun redimensioning
    [Nmirror.sch]
2025-08-16 xschem/test_Nmirror_DC.sch : work in progress: measure g_m/I_d, g_m/g_o
    [test_Nmirror_DC.sch]
2025-08-16 AnalogFlow.md : actually characterize the current sources before final layout
2025-08-16 xschem/test_Nmirror_DC.sch : plot gm/Id, gm/go of transistors. Work in progress, now dimension the transistors
    [test_Nmirror_DC.sch]
2025-08-16 xschem/pcascsrc.sch pcascsrc.sym test_pcascsrc_DC.sch : testing cascoded source as laid out
    [pcascsrc.sch, test_pcascsrc_DC.sch]
2025-08-16 xschem/test_pcascsrc_DC.sch : plot gm/Id and gm/go
    [test_pcascsrc_DC.sch]
2025-08-16 xschem/test_pcascsrc_DC.sch : bias cascodes relative to source bias
    [test_pcascsrc_DC.sch]
2025-08-16 xschem/test_pcascsrc_DC.sch : vary output voltage, 10nA ... 1uA bias
    [test_pcascsrc_DC.sch]
2025-08-16 Pmirror LVS and DRC clean
    [Pmirror_StdCell.sch]
2025-08-16 xschem/test_pmosdiode.sch : test simple pmos diode as bias for the cascode, slow corner There seems to be no temperature dependence of the models
    [test_pmosdiode.sch]
2025-08-16 xschem/test_pmosdiode.sch : test simple pmos diode as bias for the cascode, fast corner There seems to be no temperature dependence of the models
    [test_pmosdiode.sch]
2025-08-16 xschem/test_pcascsrc_DC.sch : use diode connected pmos transistor to generate cascode bias
    [test_pcascsrc_DC.sch]
2025-08-16 xschem/test_pcascsrc_DC.sch : use diode connected pmos transistor to generate cascode bias, fast corner
    [test_pcascsrc_DC.sch]
2025-08-16 xschem/test_pcascsrc_DC.sch : use diode connected pmos transistor to generate cascode bias, slow corner
    [test_pcascsrc_DC.sch]
2025-08-16 xschem/test_pcascsrc_DC.sch : use diode connected pmos transistor to generate cascode bias, typical (non-)corner
    [test_pcascsrc_DC.sch]
2025-08-17 gds/swcascsrc_playground.gds : add NWELL pin
2025-08-17 xschem/pcascsrc.sch pcascsrc.sym test_pcascsrc_DC.sch : add separate NWELL pin for LvS
    [pcascsrc.sch, test_pcascsrc_DC.sch]
2025-08-17 gds/swsources16.gds : connect VDD and NWELL, connect Iout, tbd: wire cascode switches
2025-08-17 gds/swcascsrc_playground.gds PCASCSRC_extracted.cir : switch contact to metal2, LvS clean
2025-08-17 gds/swsources16.gds : DRC clean, with switch inputs
2025-08-17 xschem/pcascsrc16.sch pcascsrc16.sym : row of 16 switched current sources
    [pcascsrc16.sch]
2025-08-17 gds/PCASCSRC16_extracted.cir xschem/simulation/pcascsrc16.spice : layout and schematic extracted netlists, LvS matches
2025-08-17 xschem/test_pcascsrc16_DC.sch : test circuit with 2 unit sources at the ends of the array as reference current input and end-of-row sources (for better matching)
    [test_pcascsrc16_DC.sch]
2025-08-17 thermometer encoder simulated and implemented using librelane
2025-08-17 gds/PCASCSRC_extracted.cir : extracted schematic from LvS, clean
2025-08-18 gds/pcascsrc.gds : add substrate tap, get rid of separate NWELL pin
2025-08-18 change schematics to reflect added well tap to pcascsrc layout
    [pcascsrc.sch, pcascsrc16.sch, test_pcascsrc16_DC.sch, test_pcascsrc_DC.sch]
2025-08-18 added non_overlap but it fails due to logic loop, it needs to be an analog block
    [heichips25_template.sv, non_overlap.sv]
2025-08-18 First run of the digital flow
2025-08-18 AnalogFlow.md : document some analog layout gotchas, in case someone wonders why there is no apparent progress
2025-08-18 analog non_overlap module
    [non_overlap.sch, non_overlap_dc_sim.sch, non_overlap_single_dc_sim.sch, non_overlap_top.sch, non_overlap_tran_logic.sch]
2025-08-18 pcascsrc.gds switched_pmos_cascode.gds PCASCSRC_extracted.cir : changed Iout pin, LvS clean
2025-08-18 pcascsrc.gds PCASCSRC_extracted.cir : top pin to metal1, LvS clean
2025-08-18 switched_pmos_cascode.gds pcascsrc.gds PCASCSRC_extracted.cir : corrected minimum metal1 area DRC error, LvS clean
2025-08-19 gds/pcascrefL.gds pcascrefR.gds PCASCSRCREFL_extracted.cir PCASCSRCREFR_extracted.cir : left and right diode connected end columns no LvS attempted
2025-08-19 pcsource.gds PCSOURCE_extracted.cir : switched cascoded source with metal1 VbiasP, extracted netlist, no LvS yet
2025-08-19 xschem/pcsource.sch pcsource.sym xschem/simulation/pcsource.spice gds/PCSOURCE_extracted.cir : (backannotated) schematic and symbol, extracted netlist from layout, LvS matches
    [pcsource.sch]
2025-08-19 xschem/pcsource16.sch pcsource16.sym test_pcsource_DC.sch test_pcsource16_DC.sch : DC test schematics for pcsource, 16 unit pcsource array
    [pcsource16.sch, test_pcsource16_DC.sch, test_pcsource_DC.sch]
2025-08-19 pcsource66.gds : 64+2 sources in a row (2 in, 64 out), not yet wired
2025-08-19 change location of analog files and simulation of analog non-overlap module now works
    [non_overlap.sch, non_overlap_dc_sim.sch, non_overlap_single_dc_sim.sch, non_overlap_single_tran_sim.sch, non_overlap_top.sch]
2025-08-19 gds/pcsource66x2.gds : array with two rows of 66 unit sources each, rotated by 180 degrees, not wired yet
2025-08-19 remove digital non_overlap source from the config file and add obstruction for analog circuit integration
2025-08-20 xschem/non_overlap*.sch non_overlap*.sym : copied from src/xschem/non_overlap
    [non_overlap.sch, non_overlap_dc_sim.sch, non_overlap_single_dc_sim.sch, non_overlap_top.sch, non_overlap_tran_logic.sch]
2025-08-20 xschem/non_overlap_tran_logic.sch non_overlap_single_dc_sim.sch : standard cell libraries included, simulation runs now and yields rather bad results
    [non_overlap_single_dc_sim.sch, non_overlap_tran_logic.sch]
2025-08-20 pymacros/switched_pmos_cascode.lym : basic pCell to draw a switched PMOS cascode
2025-08-21 gds/refsource_connect.gds : wire to turn pcsource.gds into input reference, work in progress
2025-08-21 xschem/non_overlap_tran_logic.sch : use .param
    [non_overlap_tran_logic.sch]
2025-08-21 non_overlap.sch non_overlap_tran_logic.sch
    [non_overlap.sch, non_overlap_tran_logic.sch]
2025-08-21 gds/dac128out4in.gds : add diode connection stubs to 2x(64+2) switched source array
2025-08-21 gds/refsource_connect.gds : change reference current source connection layout
2025-08-21 dac128out4in.gds cascodewire.gds cascodevia.gds refsource_connect.gds switchwire.gds : wired 128 bit DAC with 4 diode connected input unit transistors
2025-08-22 gds/dac_sw.gds switcharray.gds : layout placement test for DAC_SW, minimal version. Pitch: 1.53 um
2025-08-24 hand routed non_overlap from standard cells
    [non_overlap.sch]
2025-08-24 Add xschem non-overlap switches
    [non_overlap.sch, non_overlap_tran_logic.sch]
2025-08-24 xschem/non_overlap.sch non_overlap_tran_logic.sch : named nets, tweaked .options
    [non_overlap.sch, non_overlap_tran_logic.sch]
2025-08-24 xschem/cascodeswitch_pmos.sch cascodeswitch_pmos.sym : nicely redrawn schematic
    [cascodeswitch_pmos.sch]
2025-08-24 xschem/switch_logic.sch switch_logic.sym test_switchedsources_tran.sch : switched source transient test platform
    [switch_logic.sch, test_switchedsources_tran.sch]
2025-08-25 xschem/test_switchedsources_tran.sch : test switching behavior
    [test_switchedsources_tran.sch]
2025-08-25 xschem/pcascsrc.sch pcascsrc.sym test_pcascsrc_DC.sch test_pcsource_DC.sch test_switchedsources_tran.sch : now with parameter passing
    [pcascsrc.sch, test_pcascsrc_DC.sch, test_pcsource_DC.sch, test_switchedsources_tran.sch]
2025-08-25 xschem/non_overlap_tran_logic.sch : now with temperature dependence
    [non_overlap_tran_logic.sch]
2025-08-25 xschem/non_overlap.sch non_overlap_top.sym
    [non_overlap.sch]
2025-08-25 xschem/non_overlap_single_tran_sim.sch non_overlap_luis.sch non_overlap_luis.sym : from Luis
    [non_overlap_luis.sch, non_overlap_single_tran_sim.sch]
2025-08-25 xschem/switch_logic_RS_dly3.sch switch_logic_RS_dly3.sym test_switchedsources_tran.sch : Luis's RS latch creates an OVERLAPPING clock :-/
    [switch_logic_RS_dly3.sch, test_switchedsources_tran.sch]
2025-08-25 xschem/test_switchedsources_tran.sch : get rid of redundant plot
    [test_switchedsources_tran.sch]
2025-08-25 xschem/non_overlap.sch switch_logic_RS_dly3.sch : make the switch logic NON-overlapping instead of overlapping
    [non_overlap.sch, switch_logic_RS_dly3.sch]
2025-08-25 xschem/switch_logic_RS.sch switch_logic_RS.sym test_switchedsources_tran.sch : level shifter as non-overlapping logic
    [switch_logic_RS.sch, test_switchedsources_tran.sch]
2025-08-25 sudelbuecher/switch_logic_RS.png : level shifter circuit as non-overlapping signal generator. Transistor size matters.
2025-08-26 src/thermometer_encoder.sv : fix typo
    [thermometer_encoder.sv]
2025-08-26 gds/dac_sw.gds switcharray.gds : communicate work-in-progress
2025-08-26 gds/switcharray.gds : work in progress
2025-08-26 xschem/nonoverlap.sch nonoverlap.sym simulation/nonoverlap.spice : non-overlap RS latch as laid out
    [nonoverlap.sch]
2025-08-26 xschem/switch_logic_nonoverlap.sch switch_logic_nonoverlap.sym test_switchedsources_tran.sch : simulat non-overlap latch as laid out
    [switch_logic_nonoverlap.sch, test_switchedsources_tran.sch]
2025-08-26 nonoverlap.sch simulation/nonoverlap.spice : fix nmos length
    [nonoverlap.sch]
2025-08-26 gds/dac_sw.gds switcharray.gds : DRC clean, work in progress
2025-08-27 gds/cascodedrive.gds switcharray.gds : move origin, fix DRC error
2025-08-27 sudelbuecher/nonoverlap_*.png : screenshots of nonoverlap blocks that tend to get optimized away by the digital synthesis flow
2025-08-27 gds/pcsource2u.gds : Towards a 2um width switched current source. Work in progress
2025-08-27 gds/pcsource2u.gds PCSOURCE2U_extracted.cir xschem/pcsource2u.sch pcsource2u.sym simulation/pcsource2u.spice : resized source witch schematic, symbol, and netlists for (clean) LvS
    [pcsource2u.sch]
2025-08-27 xschem/* : adapt test schematics to altered layout, make parametric, add bypass capacitors
    [pcascsrc16.sch, pcsource16.sch, test_pcascsrc16_DC.sch, test_pcascsrc_DC.sch, test_pcsource16_DC.sch, test_pcsource_DC.sch, test_switchedsources_tran.sch]
2025-08-27 gds/pcsource2u.gds gds/PCSOURCE2U_extracted.cir xschem/pcsource2u.sch xschem/simulation/pcsource2u.spice : cascode length now 0.6u (it's easier to make it shorter than longer)
    [pcsource2u.sch]
2025-08-27 xschem/cascodeswitch_pmos.sch : match w=0.3u as in layout
    [cascodeswitch_pmos.sch]
2025-08-27 gds/cascodedrive.gds gds/CASCODEDRIVE_extracted.cir xschem/cascodedrive.sch xschem/simulation/cascodedrive.spice : create schematic for cascodedrive.gds, LvS matches
    [cascodedrive.sch]
2025-08-27 gds/unitsource2u.gds gds/UNITSOURCE2U_extracted.cir xschem/unitsource2u.sch xschem/simulation/unitsource2u.spice : alignable 2 um wide switched unit source, DRC and LvS clean
    [unitsource2u.sch]
2025-08-28 xschem/cascodeswitch_pmos.sch test_pcsource_DC.sch : .55/2 .3/.3 sizes, bias 6/.15, labeled plots in ngspice : this look sane
    [cascodeswitch_pmos.sch, test_pcsource_DC.sch]
2025-08-28 xschem/test_pcascsrc_DC.sch : ngspice plots with titles now
    [test_pcascsrc_DC.sch]
2025-08-28 xschem test_pcascsrc16_DC.sch : multiplicity of sources now a design variable
    [test_pcascsrc16_DC.sch]
2025-08-28 xschem/cascodeswitch_pmos.sch : as laid out
    [cascodeswitch_pmos.sch]
2025-08-28 test_pcascsrc_DC.sch : .temp instead of .param temp
    [test_pcascsrc_DC.sch]
2025-08-28 xschem/test_pcascsrc_mult_DC.sch : multiplicity of sources as parameter
    [test_pcascsrc_mult_DC.sch]
2025-08-28 xschem/test_pcascsrc_mult_DC.sch : works with dimensions as laid out, currents: 32 out 2 in
    [test_pcascsrc_mult_DC.sch]
2025-08-28 xschem/test_pcascsrc_mult_DC.sch : works for 64 output 2 input currents
    [test_pcascsrc_mult_DC.sch]
2025-08-28 xschem/test_pcascsrc_mult_DC.sch : works for 128 output 4 input currents
    [test_pcascsrc_mult_DC.sch]
2025-08-28 xschem/test_pcascsrc_mult_DC.sch : op convergence problems for 256 output 8 input currents
    [test_pcascsrc_mult_DC.sch]
2025-08-28 Revert "xschem/test_pcascsrc_mult_DC.sch : op convergence problems for 256 output 8 input currents" Back to 128 out 4 in which works This reverts commit 0c87c432688140c8a508449e554b8c0b82295166.
    [test_pcascsrc_mult_DC.sch]
2025-08-28 Revert "xschem/test_pcascsrc_mult_DC.sch : works for 128 output 4 input currents" 64 output 2 input currents work just as well, with less simulation effort.
    This reverts commit 1a9048bd19b211a8fb5a8b54a1ae46a057f52e8e.
    [test_pcascsrc_mult_DC.sch]
2025-08-28 AnalogFlow.md : update the latest schematic level simulations
2025-08-28 test_switchedsources_tran.sch : substantial pmos bypass varicap gate leakage in DC operation
    [test_switchedsources_tran.sch]
2025-08-28 xschen/test_switchedsources_tran.sch : works with HVPMOS bypass capacitors that don't leak
    [test_switchedsources_tran.sch]
2025-08-28 xschem/test_unitsource2u_DC.sch : works
    [test_unitsource2u_DC.sch]
2025-08-28 xschem/test_unitsource2u_tran.sch test_unitsource2u_DC.sch : use unitsource2u as reference, too. Work with one input, one output current
    [test_unitsource2u_tran.sch]
2025-08-28 xschem/test_unitsource2u_DC.sch : 2 input, 64 output currents. Gate leakage is a facture (and measured in this test schematic)
    [test_unitsource2u_DC.sch]
2025-08-28 xschem/complementary_driver.sch .sym : digital complementary driver for unitsource2u
    [complementary_driver.sch]
2025-08-28 test_unitsource2u_DC.sch : use complementary_driver subcircuit
    [test_unitsource2u_DC.sch]
2025-08-28 xschem/test_unitsource2u_tran.sch : works with 1 input 1 output current with HVPMOS buffer capacitors
    [test_unitsource2u_tran.sch]
2025-08-28 xschem/test_unitsource2u_tran.sch : works with 1 input 1 output current. No bypass capacitors on the bias lines
    [test_unitsource2u_tran.sch]
2025-08-28 AnalogFlow.md : substantial simulation progress to report
    [test_unitsource2u_tran.sch]
2025-08-28 gds/unitsource2u66.gds unitsource2u66x2.gds : rows of 66 unit sources with pitch 2um
2025-08-29 xschem/test_unitsource2u_tran.sch : add hvpmos buffer bias buffer capacitors shorter simulation time, fewer variables
    [test_unitsource2u_tran.sch]
2025-08-29 gds/cascodebias.gds unitref2u.gds : minimum size cascode bias transistor to attach sideways to unit reference cell
2025-08-29 xschem/test_pcascsrc16_DC.sch test_pcascsrc_DC.sch test_pcascsrc_mult_DC.sch test_switchedsources_tran.sch test_unitsource2u_DC.sch test_unitsource2u_tran.sch : set width of cascode bias transistor t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
    [test_pcascsrc16_DC.sch, test_pcascsrc_DC.sch, test_pcascsrc_mult_DC.sch, test_switchedsources_tran.sch, test_unitsource2u_DC.sch, test_unitsource2u_tran.sch]
2025-08-29 gds/dac_pads.gds python/make_dac_pads.py : script to generate 2um pitch DAC pads. Start with one switched source.
2025-08-29 xschem/test_unitsource2u_tran.sch : fixed errors in plot specs, shorter simulation time
    [test_unitsource2u_tran.sch]
2025-08-29 gds/dac2u64out2in.gds gds/DAC2U64OUT2IN_extracted.cir xschem/dac2u64out2in.sch xschem/simulation/dac2u64out2in.spice : 64+2 unit cell DAC, DRC and LvS clean
    [dac2u64out2in.sch]
2025-08-29 gds/dac128out4in.gds gds/dac2u128out4in_digitalpads.gds dac2u64out2in_supplypads.gds python/make_dac_pads.py : 2um pitch DAC with 128 output 4 input currents, script generated digital pads still hier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
2025-08-29 gds/dac2u128out4in.gds gds/DAC2U128OUT4IN_extracted.cir xschem/dac2u128out4in.sch xschem/simulation/dac2u128out4in.spice : DRC and LvS clean ... ready to turn this into a LEF
    [dac2u128out4in.sch]
2025-08-30 Revert "DoNotLitter/CryoChips/Design_of_Low-Voltage_and_Low-Power_Cryogenic_CMOS_Voltage_Reference_Circuits.pdf : start literature collection"
    This reverts commit 91d62f9fe9cc84ca0cffa3e9febb424ad38485a1.
2025-08-31 librelane/config.yaml librelane/constraints/pudding_min.sdc : unsystematic trial and error to get the dac2u128out4in module to connect to power
2025-08-31 librelane/config.yaml : more trial and error to connect dac2u128out4in to power
2025-08-31 gds/dac2u128out4in.lef : comment out analog non-power pins
2025-08-31 librelane/config.yaml src/dac2u128out4in.v : try to wire unused terminals to _unused. This doesn't work
    [dac2u128out4in.v]
2025-08-31 pix/dac128out4in_metal3wires.* : wiring target LEF
2025-08-31 librelane/config.yaml : tried to move the origin of the macros, still doesn't connect to the power routing
2025-08-31 pix/dac128out4in_metal1wires.* : old wiring target LEFs (narrow-ish metal1)
2025-09-01 librelane/config.yaml src/heichips25_pudding.sv src/dac2u128out4in.v : yet another failed attempt at routing power
    [dac2u128out4in.v, heichips25_pudding.sv]
2025-09-02 librelane/config.yaml : reintroduce obstruction, comment away power grid specification
2025-09-02 src/heichips25_pudding.sv inverterpair.sv : finally syntactically correct
    [heichips25_pudding.sv, inverterpair.sv]
2025-09-04 dac2u128out4in.gds dac2u128out4in_extracted.cir : text to text layers, LvS clean (although identical circuits may be assigned randomly)
2025-09-05 gds/dac2u128out4in.gds : klayout wants me to save this again, so just in case, I do it.
2025-09-05 gds/dac128module_pins.gds : pins for dac128 including metal 5 power pads
2025-09-05 gds/dac128module_extracted.cir xschem/dac128module.sch xschem/simulation/dac128module.spice : LvS clean with lots of ambiguous net matches
    [dac128module.sch]
2025-09-06 dac128module.lef : DIRECTION INOUT ; for power pads. Doesn't make a difference in itself
2025-11-08 librelane/runs/RUN_2025-11-07_13-11-03/ : lots of reports for troubleshooting
    [heichips25_pudding__nom_fast_1p32V_m40C.sdf, heichips25_pudding__nom_slow_1p08V_125C.sdf, heichips25_pudding__nom_typ_1p20V_25C.sdf, metrics.csv]
2026-02-07 sudelbuecher/makelogs/make20260207_1454.out .err : run with updated analog flow
2026-02-07 librelane/runs/RUN_2026-02-07_14-50-31/ : first run after analog flow update, lots of reports
    [heichips25_pudding__nom_fast_1p32V_m40C.sdf, heichips25_pudding__nom_slow_1p08V_125C.sdf, heichips25_pudding__nom_typ_1p20V_25C.sdf, metrics.csv]
2026-02-09 librelane/runs/RUN_2026-02-09_01-34-10/ : run reports to document DRC
    [heichips25_pudding__nom_fast_1p32V_m40C.sdf, heichips25_pudding__nom_slow_1p08V_125C.sdf, heichips25_pudding__nom_typ_1p20V_25C.sdf, metrics.csv]
2026-02-09 librelane/runs/RUN_2026-02-09_03-13-23/* : reports of successful make macro run
    [heichips25_pudding__nom_fast_1p32V_m40C.sdf, heichips25_pudding__nom_slow_1p08V_125C.sdf, heichips25_pudding__nom_typ_1p20V_25C.sdf, metrics.csv]
2026-02-10 sudelbuecher/makelogs/make20260209_1400.log .err : updated librelane flow, failed synthesis
2026-02-10 librelane/runs/RUN_2026-02-09_04-26-24/ : run logs of failed-to-route run with updated librelane flow
    [heichips25_pudding__nom_fast_1p32V_m40C.sdf, heichips25_pudding__nom_slow_1p08V_125C.sdf, heichips25_pudding__nom_typ_1p20V_25C.sdf, metrics.csv]
2026-02-11 macro/ : successfully synthesized, DRC clean heichips25_pudding macro
    [heichips25_pudding__nom_fast_1p32V_m40C.sdf, heichips25_pudding__nom_slow_1p08V_125C.sdf, heichips25_pudding__nom_typ_1p20V_25C.sdf, metrics.csv]
2026-02-11 librelane/runs/RUN_2026-02-11_00-01-28/final/ module successfully generated
    [heichips25_pudding__nom_fast_1p32V_m40C.sdf, heichips25_pudding__nom_slow_1p08V_125C.sdf, heichips25_pudding__nom_typ_1p20V_25C.sdf, metrics.csv]
2026-02-12 macro/* : successful make
    [heichips25_pudding__nom_fast_1p32V_m40C.sdf, heichips25_pudding__nom_slow_1p08V_125C.sdf, heichips25_pudding__nom_typ_1p20V_25C.sdf, metrics.csv]
2026-02-12 macro/* : successful make macro, analog pins not connected yet
    [heichips25_pudding__nom_fast_1p32V_m40C.sdf, heichips25_pudding__nom_slow_1p08V_125C.sdf, heichips25_pudding__nom_typ_1p20V_25C.sdf, metrics.csv]
2026-02-12 files copied from heichips25-tapeout repository : clean analog slates
    [pins_cryo.cfg, pins_fg.cfg]
2026-02-12 macro/ : baby steps towards hooking up analog pins, so far so good
    [heichips25_pudding__nom_fast_1p32V_m40C.sdf, heichips25_pudding__nom_slow_1p08V_125C.sdf, heichips25_pudding__nom_typ_1p20V_25C.sdf, metrics.csv]
2026-02-12 src/heichips25_pudding.sv src/dac128module.v gds/dac128module.lef : try to add analog pins for routing, gets stuck with 2 shorts
    [dac128module.v, heichips25_pudding.sv]
2026-02-12 macro/ : successful analog autorouting (WAY too narrow though)
    [heichips25_pudding__nom_fast_1p32V_m40C.sdf, heichips25_pudding__nom_slow_1p08V_125C.sdf, heichips25_pudding__nom_typ_1p20V_25C.sdf, metrics.csv]
2026-02-12 macro/ : moved and resized analog pins
    [heichips25_pudding__nom_fast_1p32V_m40C.sdf, heichips25_pudding__nom_slow_1p08V_125C.sdf, heichips25_pudding__nom_typ_1p20V_25C.sdf, metrics.csv]
